luchnikovaiv/atmega328p-data-logger/docs/proteus_ready.png

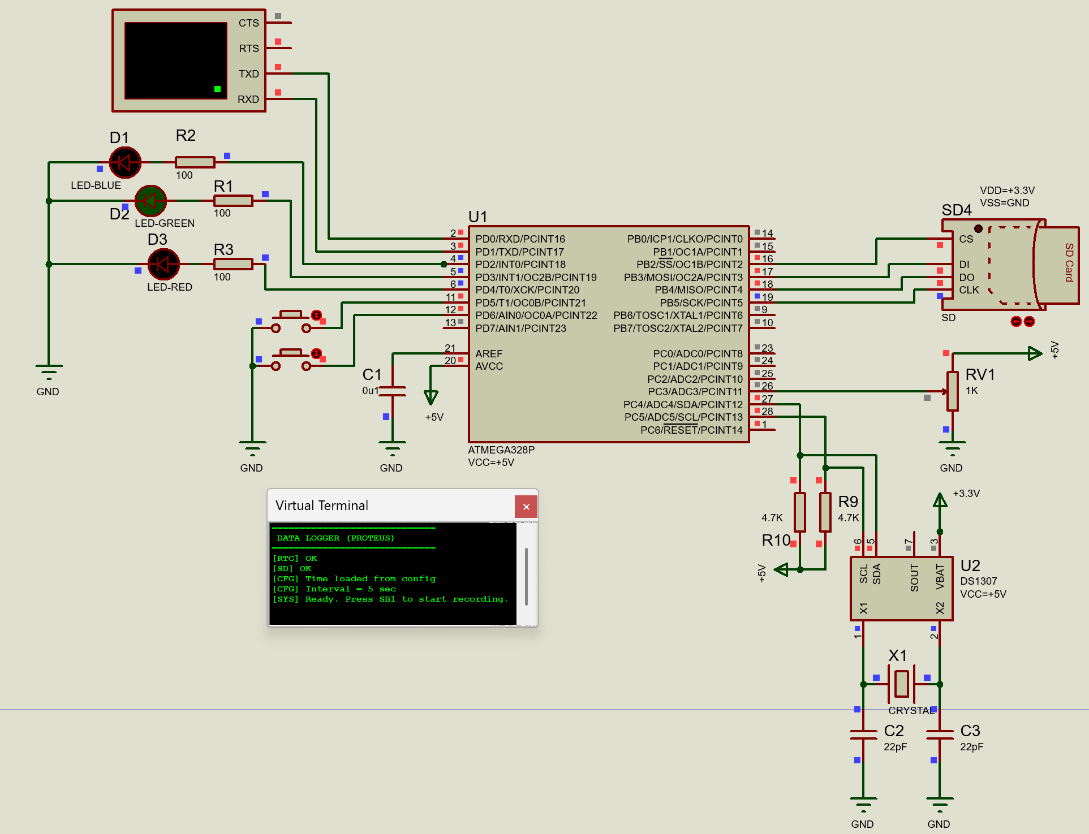
docs/proteus_ready.png
