luchnikovaiv/atmega328p-data-logger/docs/bom_pe3_page1.png

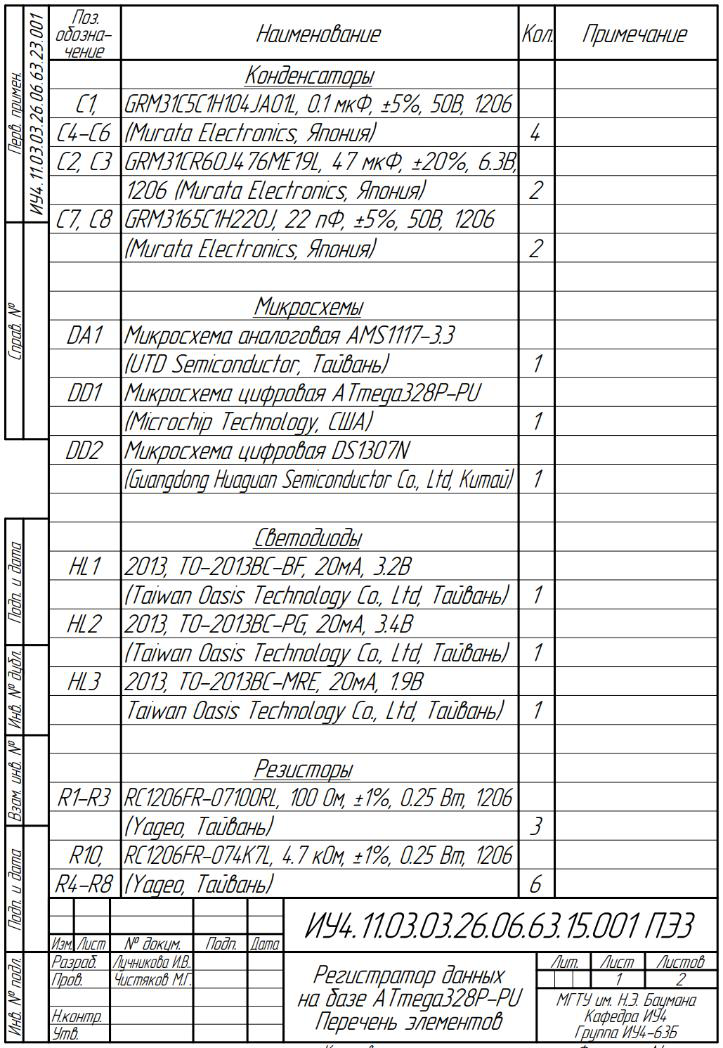
docs/bom_pe3_page1.png
