luchnikovaiv/atmega328p-data-logger/docs/bom_pe3_page2.png

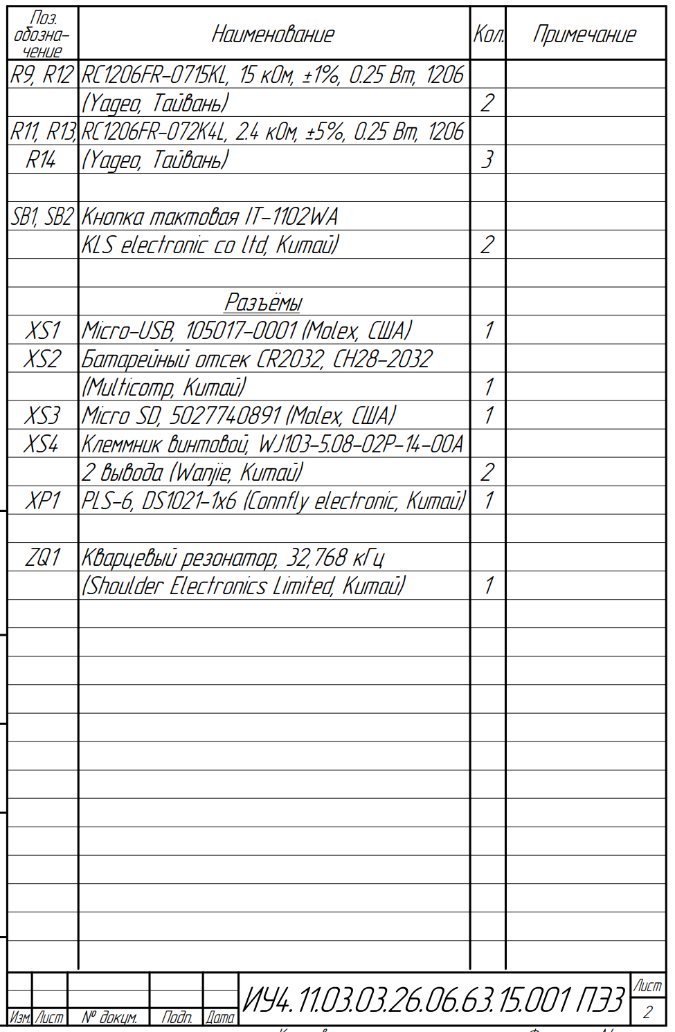
docs/bom_pe3_page2.png
