luchnikovaiv/atmega328p-data-logger/(list of files, drawings)

Other design files:
hardware/altium/data_logger.PcbDoc
hardware/altium/data_logger.SchDoc
hardware/altium/data_logger_PcbLib1.PcbLib
hardware/altium/data_logger_Schlib.SchLib
